XBFBolt/ember/design-export/index.html

Ember

Maya Chen Live · 42 min

Watch

38.1

°C± 0.7

↑ 0.3° / 10 min +1.0° since start

Estimated core temp · likely 37.4–38.8°C

36°Watch 38°Act 38.5°40°

## Can't estimate right now

High heart rate while sitting still

Your heart rate is up, but your body doesn't look like it's heating up. Ember won't show a number it can't stand behind.

Your plan Updated just now

You are heating up. Take your break now, not in 10 minutes.

Could reach 38.5° in about 10–25 min If you keep this pace. A break now resets the clock.

Next break

Now

5 min in shade

Water

Now

250 ml · last drink 22 min ago

Start my break I drank

Last 30 min HR 152 bpm · moving

Core estimate + range Skin 33.8°C

Heart rate and history stay on this phone. Not a medical device. How sure is Ember?

Preseason practice · Field 2 · started 4:05 PM · 12 straps live

# Team heat status

Air 31°C · Humidity 68% Heat index 36°C · High

## Players

Sorted by risk · ± is the measured 90% range · updates every 5 s

## Break plan

20 min on, 5 off

6 minto next team water break

Bring it forward: 3 players could reach 38.5° within 10–20 min. Each player gets 250 ml. Okafor and Brooks stay out until Ember shows Watch or OK.

Call break now Keep schedule

## Do this now

Act now

Pull J. Okafor (#22) and T. Brooks (#54) to the cooling tent. Both are over 38.5°C and still heating up.

Mark done

Next 5 min

Three players are over 38.0°C and heating up. Call the water break early. Check on S. Kim in person: Ember can't tell if their high heart rate is heat.

Rest of practice

Heat index stays high until about 6 PM. Keep 20 on, 5 off and 250 ml per break.

## Today

Athletes opted in to share status and core temp range. Heart rate and history stay on each athlete's phone. A triage signal, not an alarm or a medical device: it supports your judgment, it doesn't replace it.

Seaport site · Crew B · Shift 7:00 AM to 3:30 PM

# Heat safety events

Air 30°C Heat index 34°C · High

## You see safety events only

Temperatures, heart rate and forecasts stay private to each worker. You're told when someone needs help, not how their body is doing minute to minute.

## Events

## Crew break plan

45 on, 15 off

11:45next crew break · in 12 min

Set from today's heat index. Water and shade for everyone, about 500 ml per hour each. Ember suggests the schedule; you can change it.

## Crew

## Who sees what

Shared with you

- Overheating alerts
- Rest breaks taken
- Estimate unavailable

Only the worker sees

- Core temp estimate and range
- Heart rate and skin temp
- Motion and other sensor readings
- Full history and location
