XBFBolt/ember/analysis/ember_all_by_sex.png

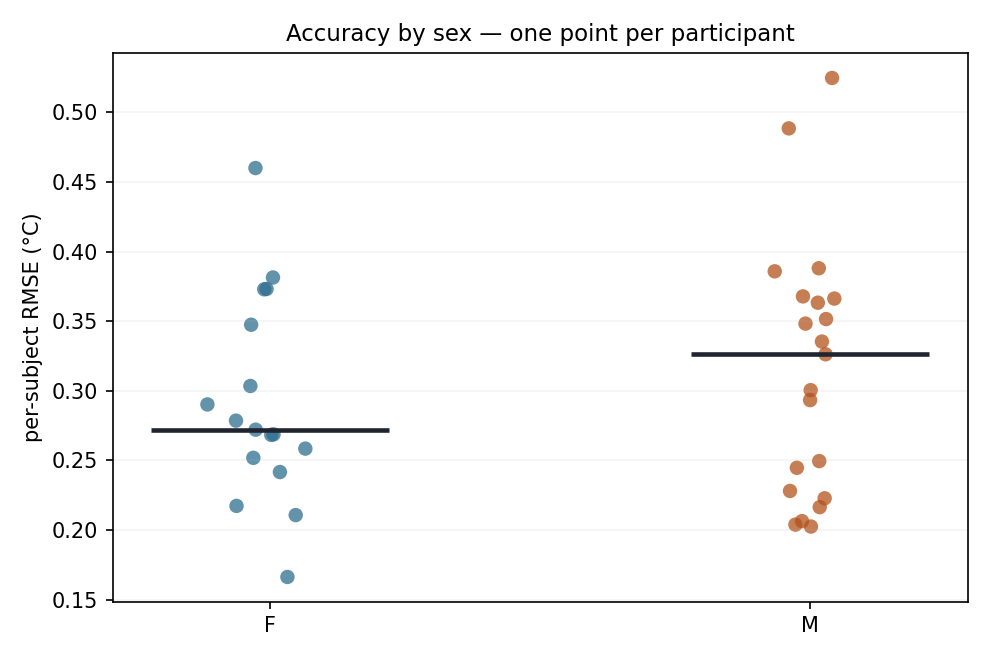
analysis/ember_all_by_sex.png
