XBFBolt/ember/analysis/judges_coverage.png

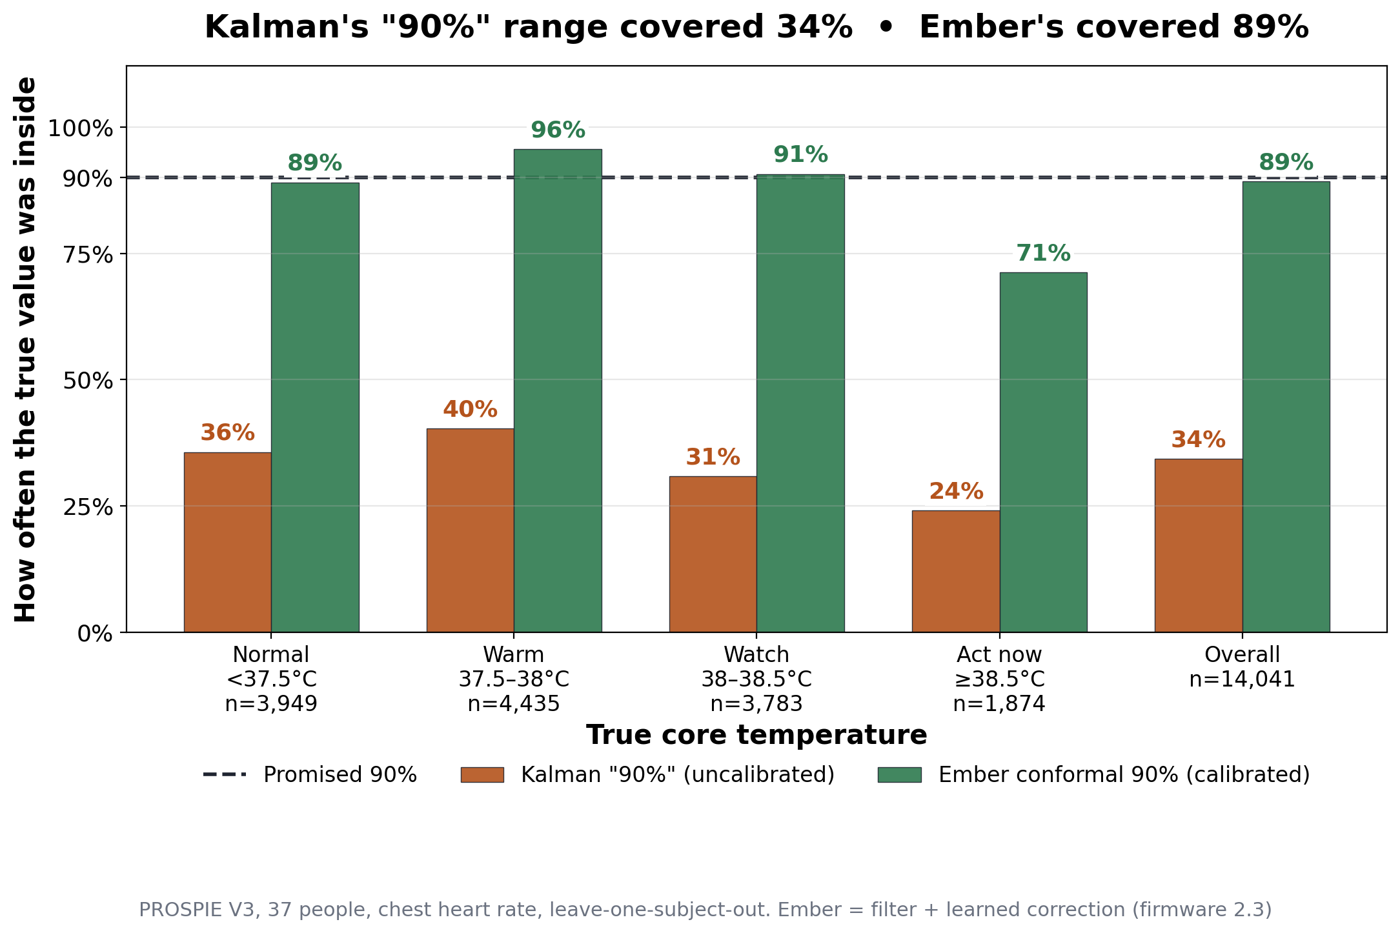
analysis/judges_coverage.png
