XBFBolt/ember/analysis/judges_lag.png

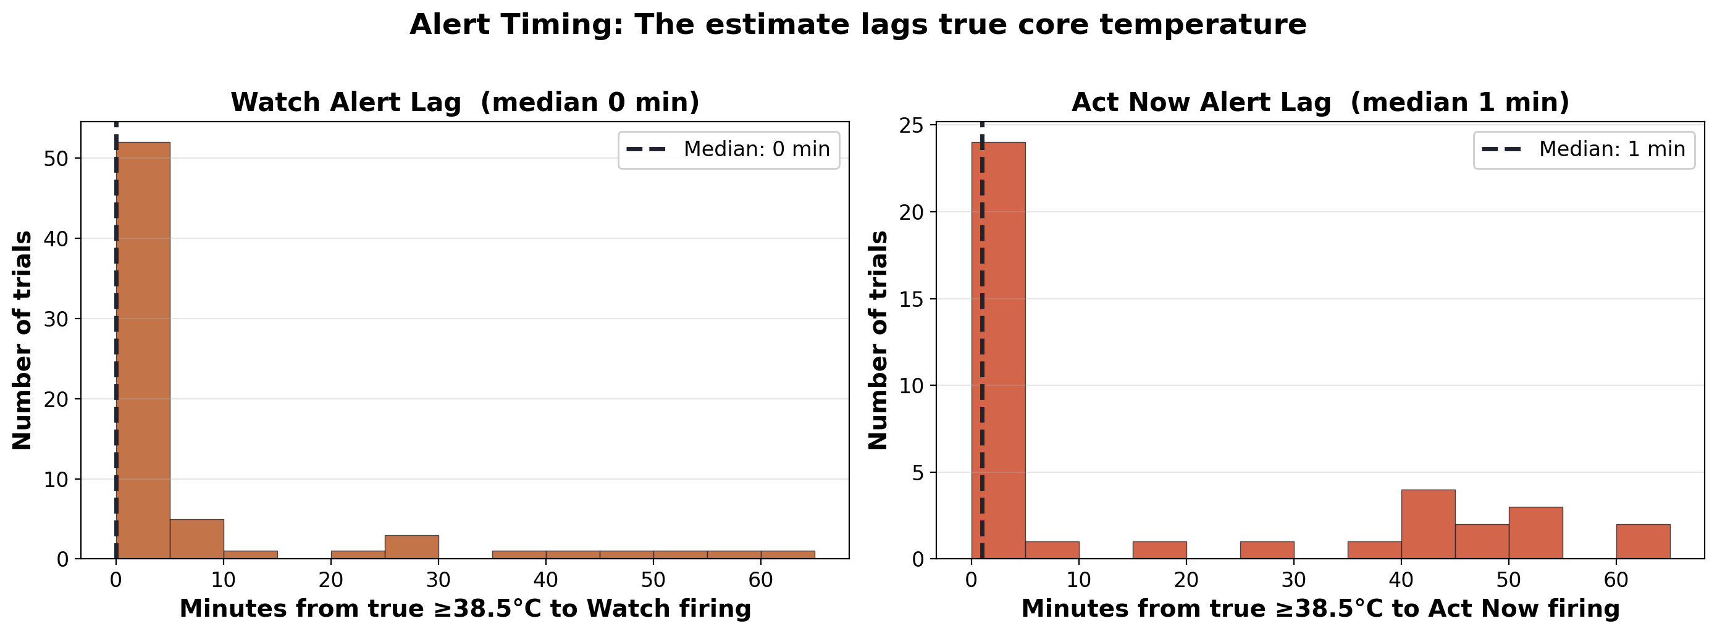
analysis/judges_lag.png
