XBFBolt/ember/analysis/judges_range.png

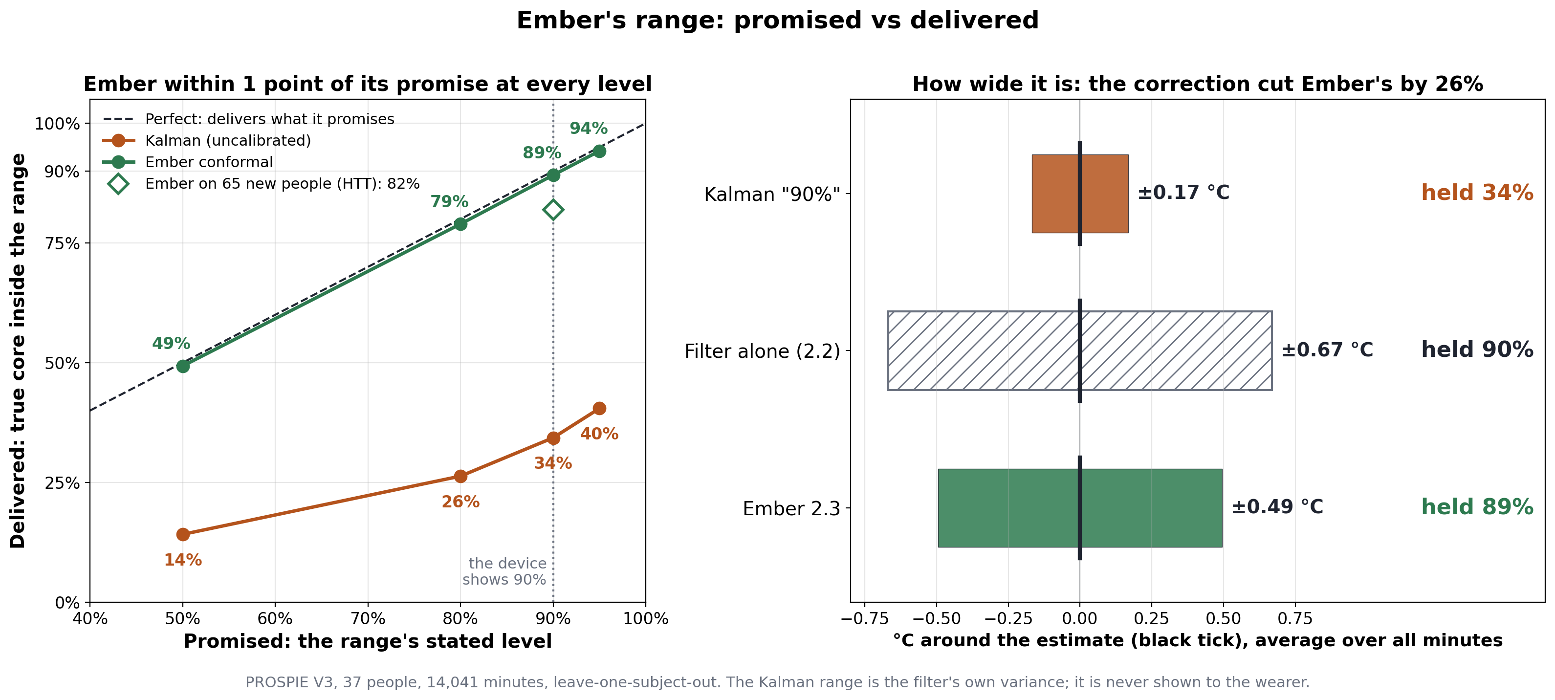
analysis/judges_range.png
