XBFBolt/ember/analysis/judges_trial_interval.png

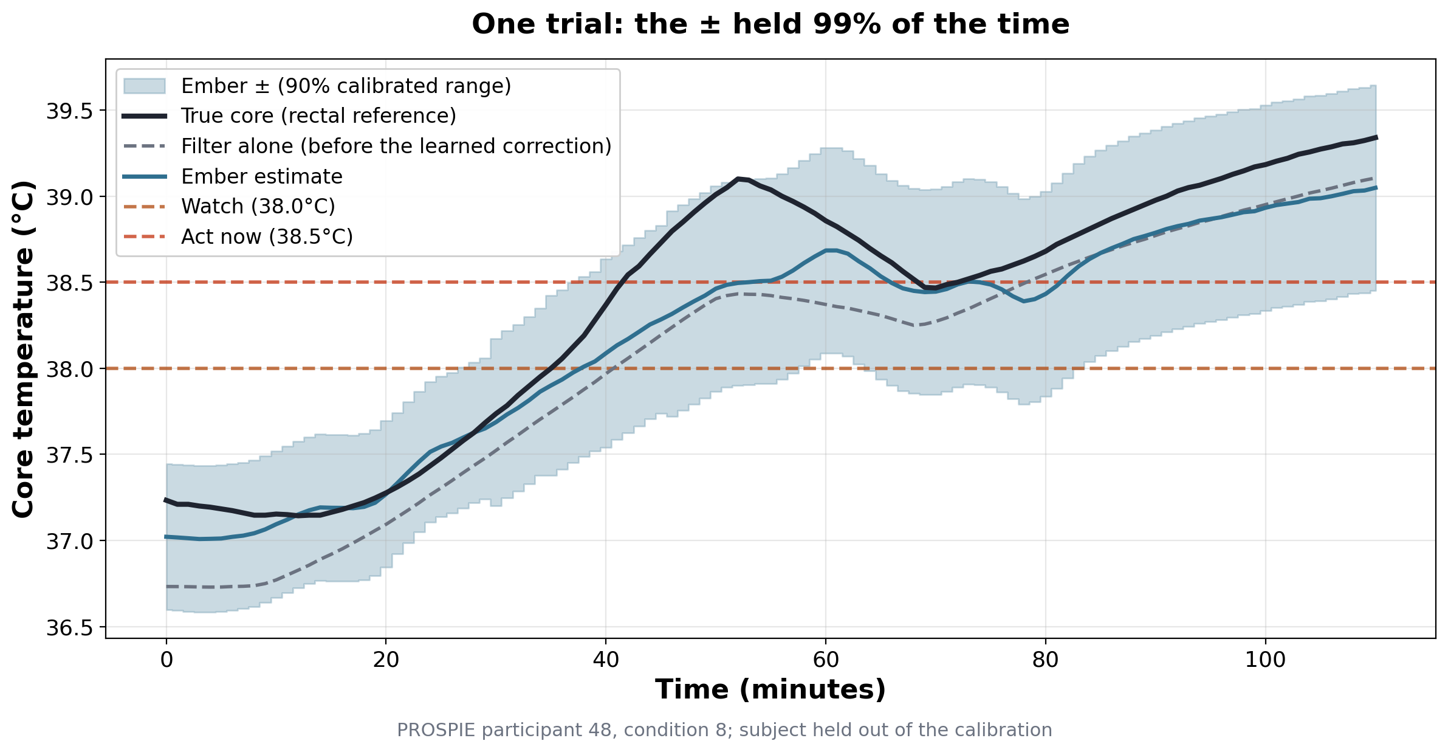
analysis/judges_trial_interval.png
