XBFBolt/ember/ember_schematic_v5.png

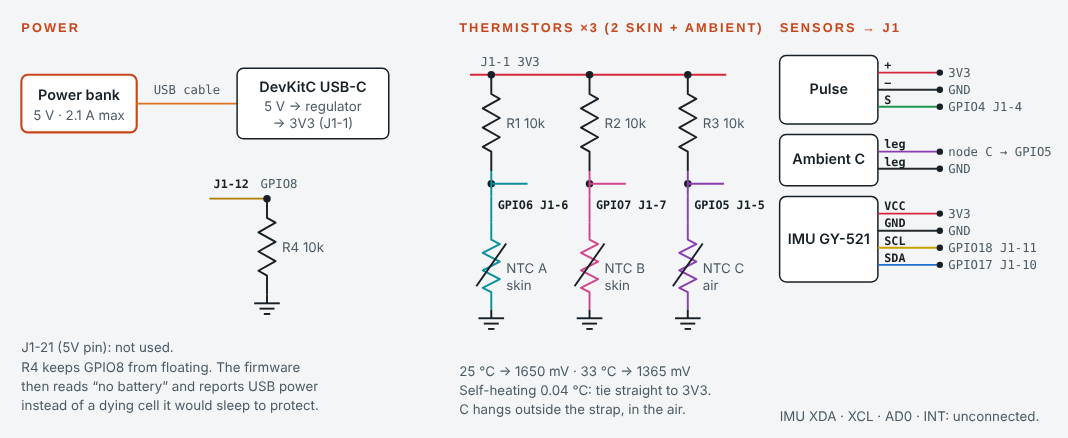
ember_schematic_v5.png
