XBFBolt/ember/figures/ember_by_sex.png

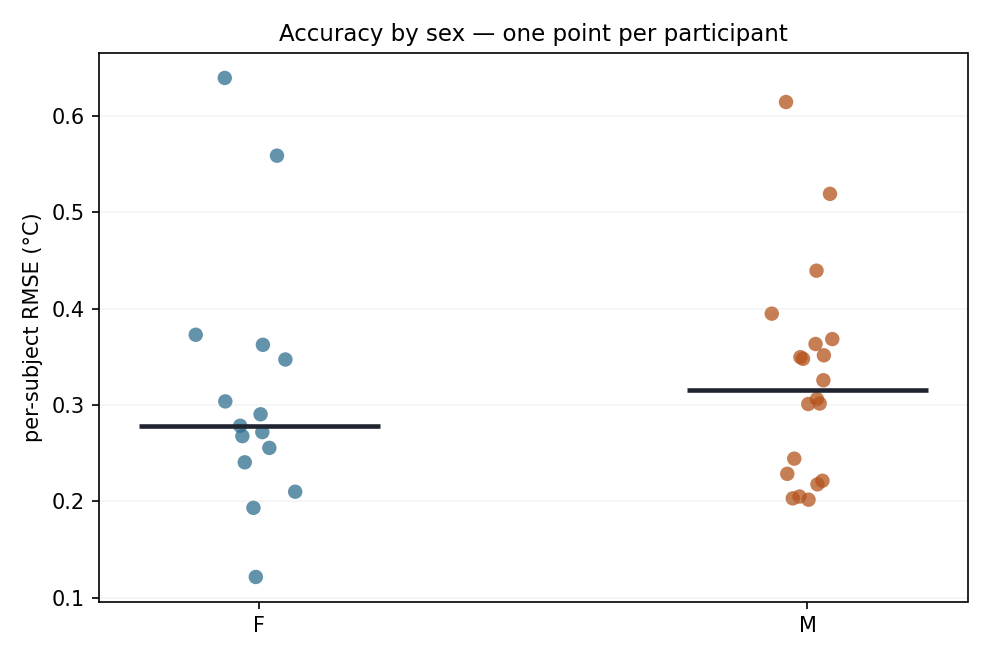
figures/ember_by_sex.png
