XBFBolt/ember/figures/judges_early_warning.png

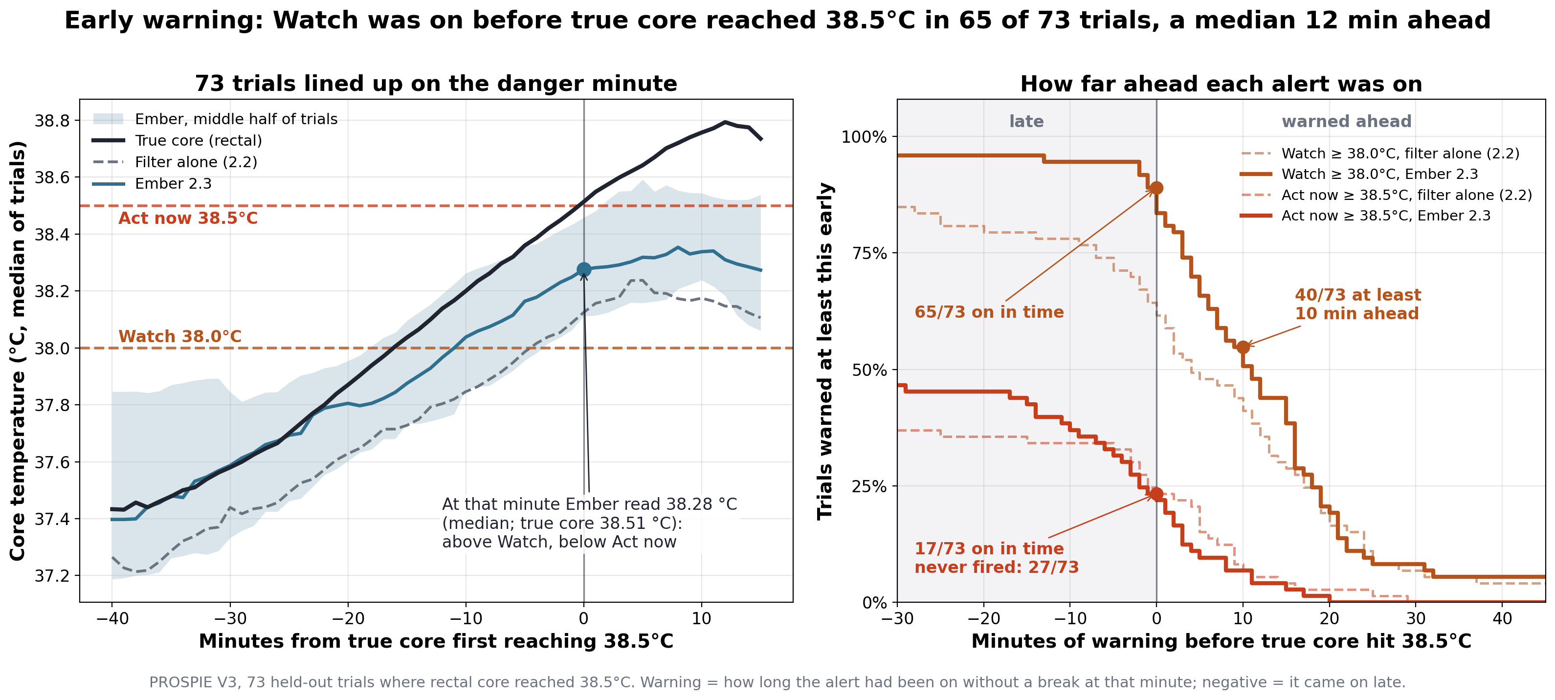
figures/judges_early_warning.png
