XBFBolt/ember/figures/judges_lag.png

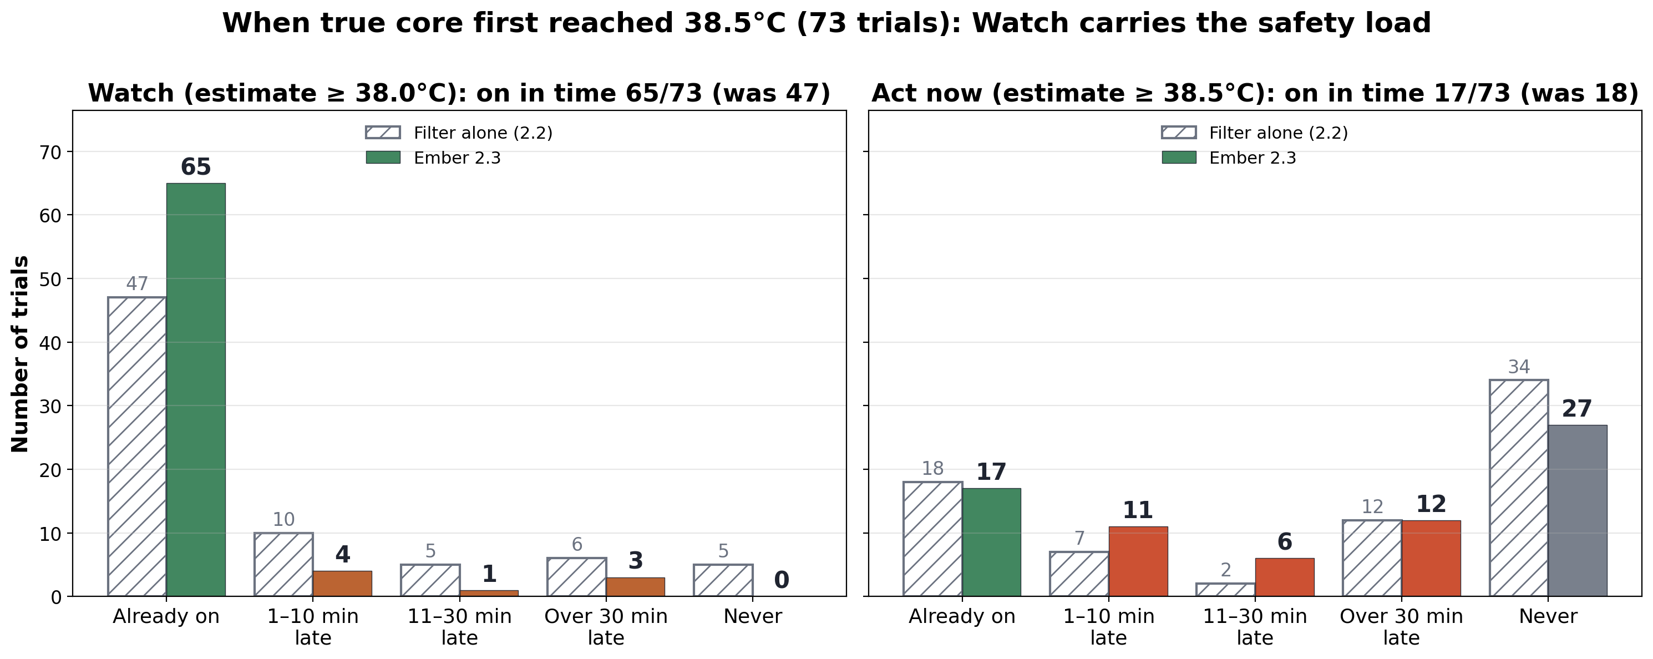
figures/judges_lag.png
