XBFBolt/ember/figures/judges_rmse.png

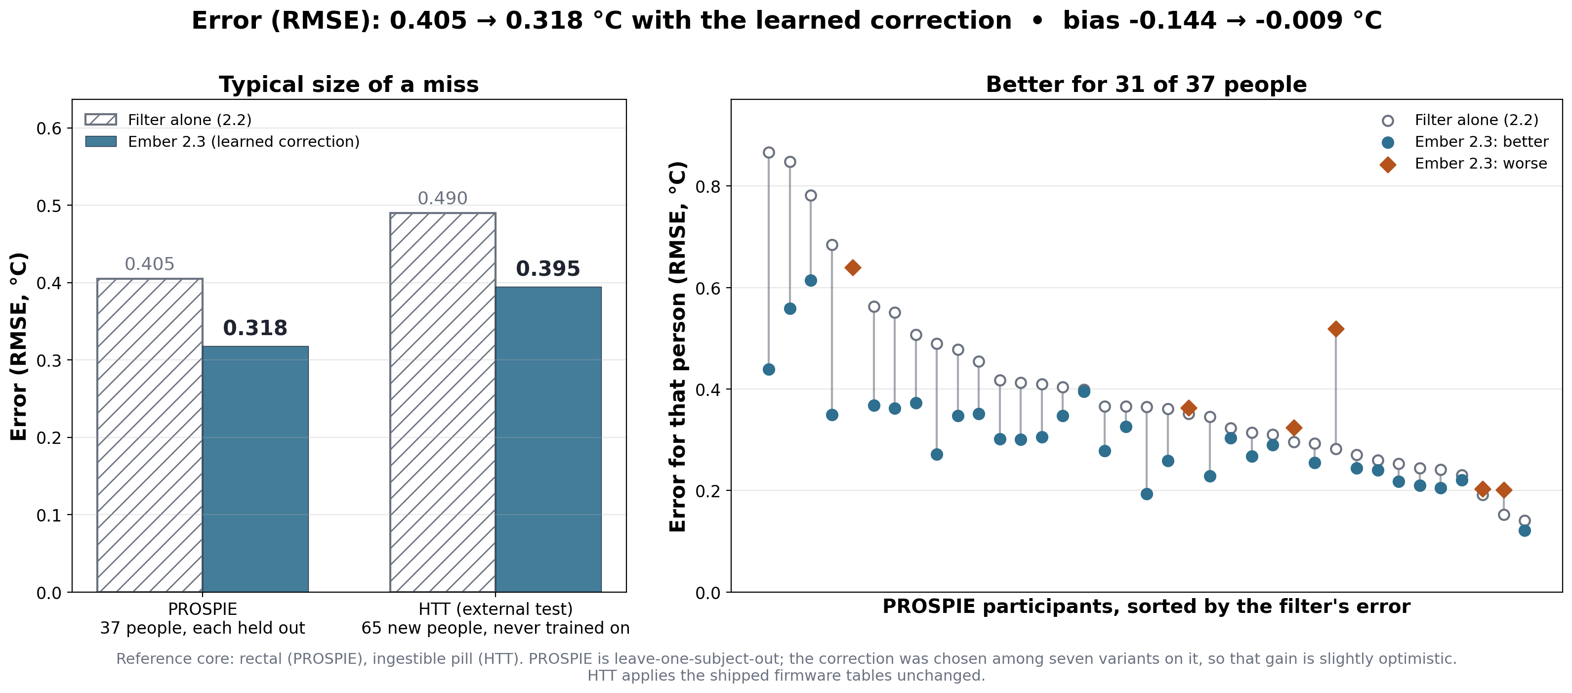
figures/judges_rmse.png
