XBFBolt/ember/figures/judges_trial_interval.png

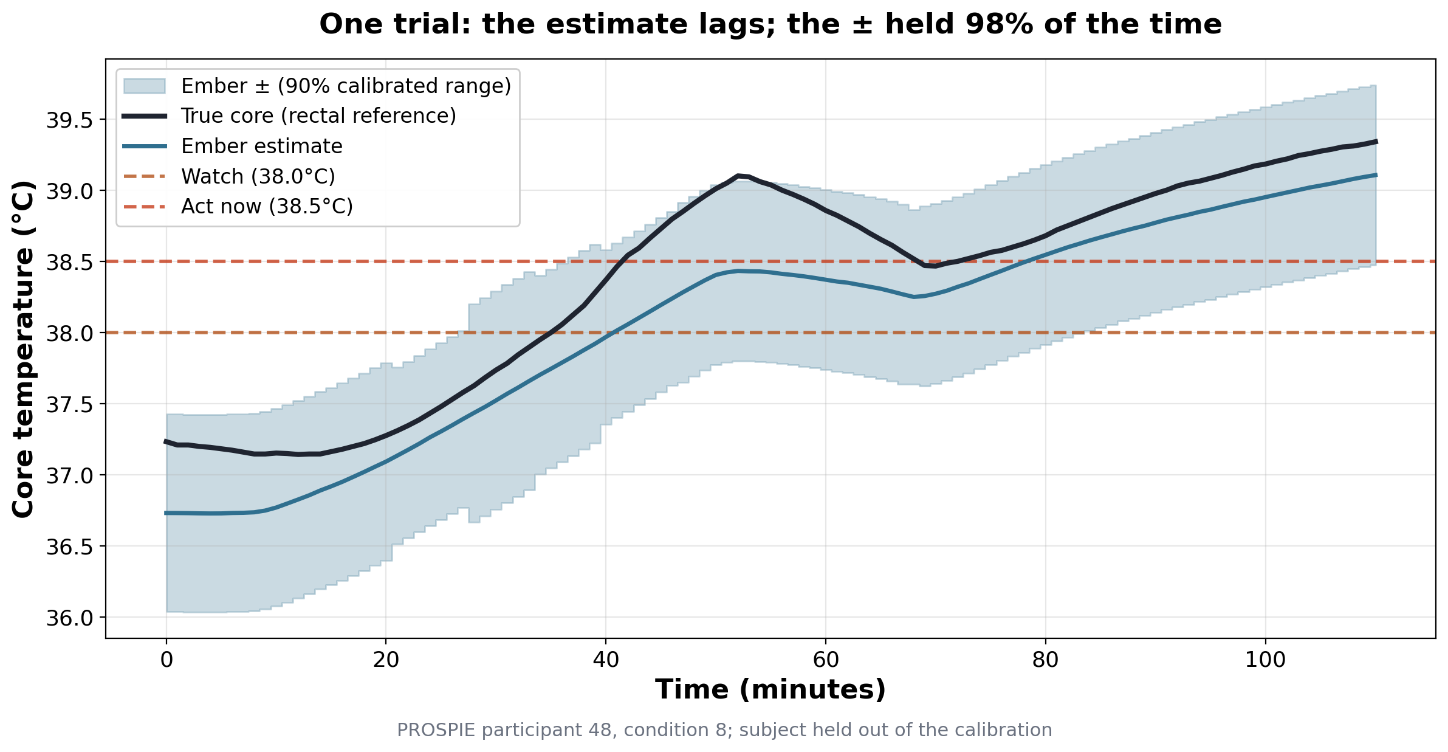
figures/judges_trial_interval.png
