XBFBolt/ember/hardware/cad/ember_underside.png

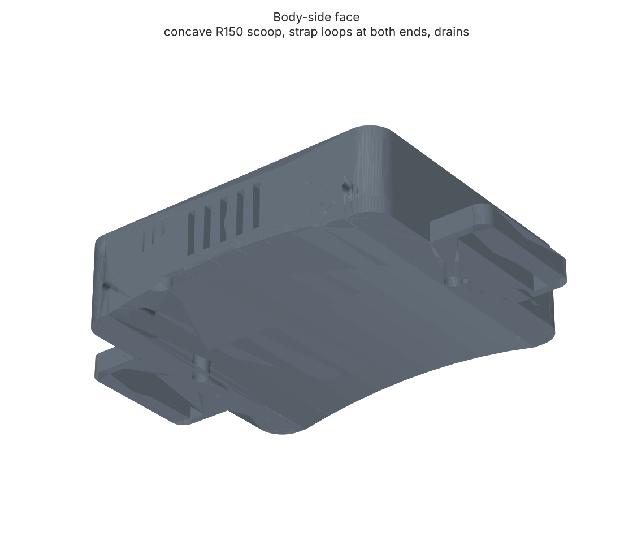
hardware/cad/ember_underside.png
