XBFBolt/ember/hardware/cad/ember_views.png

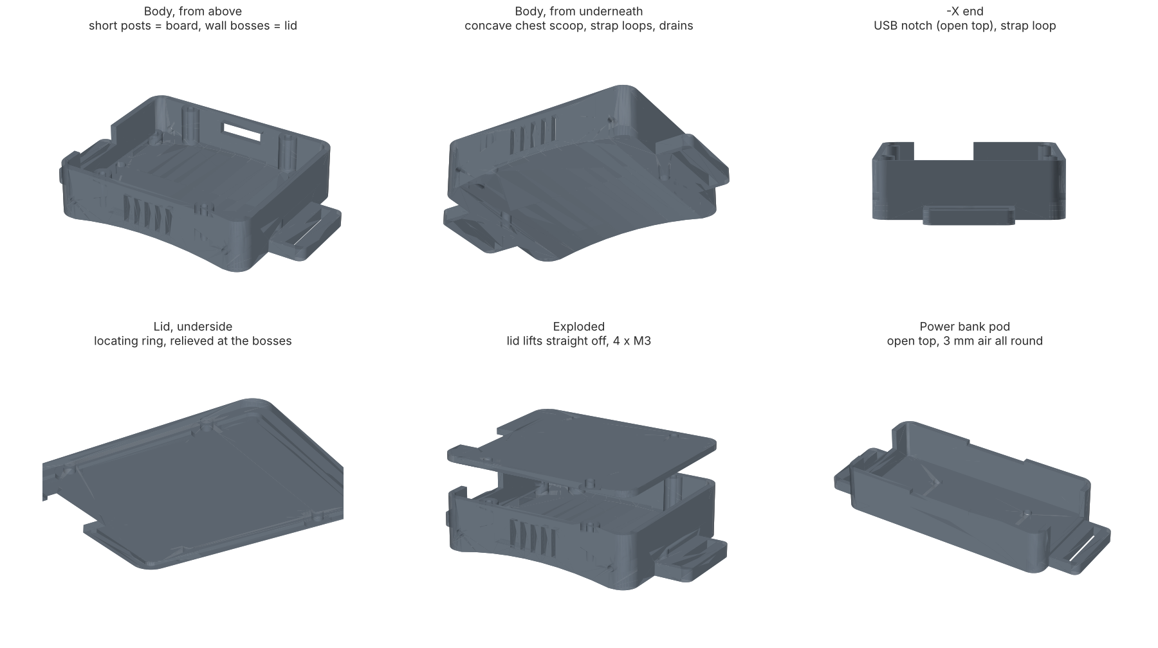
hardware/cad/ember_views.png
