XBFBolt/ember/hardware/ember_protoboard_v5.png

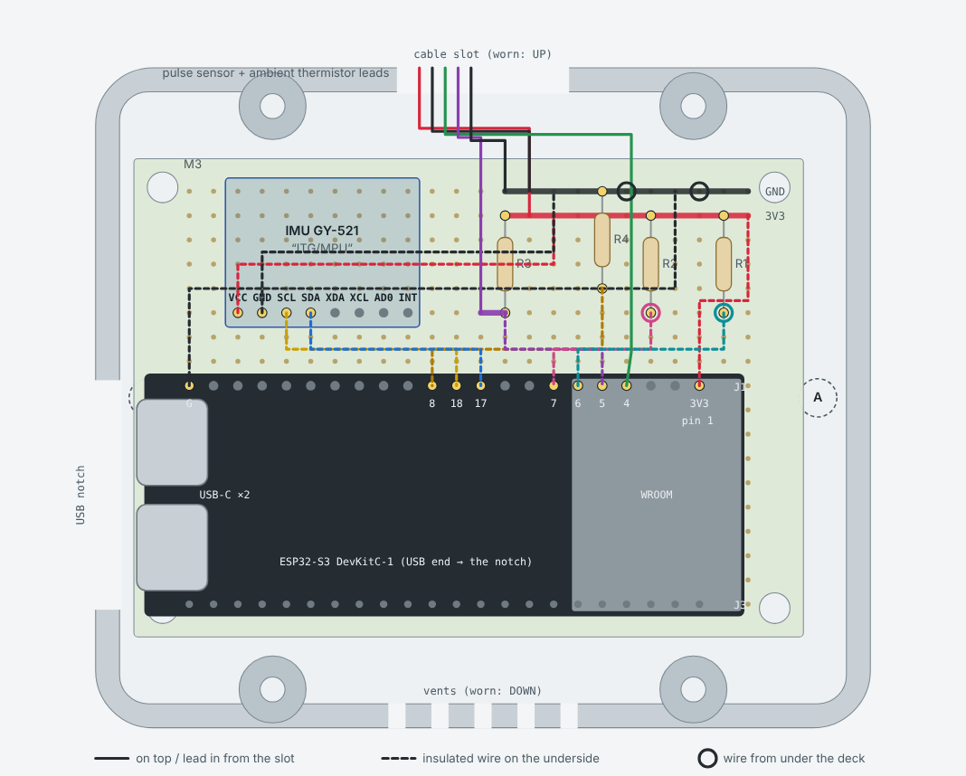
hardware/ember_protoboard_v5.png
