XBFBolt/ember/cad/ember_assembly.step

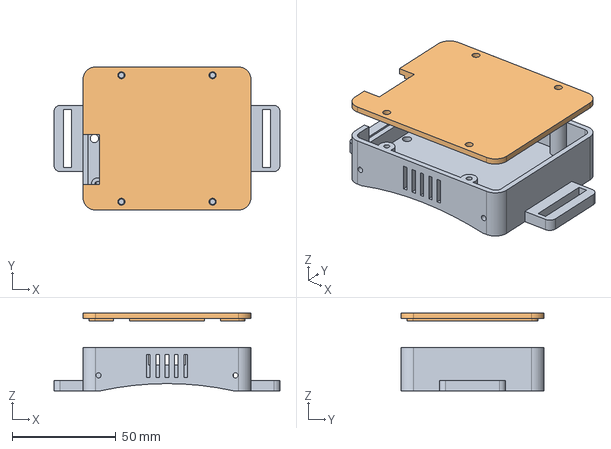
[picture p16: CAD file, 2026-10-24]
cad/ember_assembly.step
109.0 x 69.0 x 37.5 mm
