XBFBolt/ember/cad/ember_lid.step

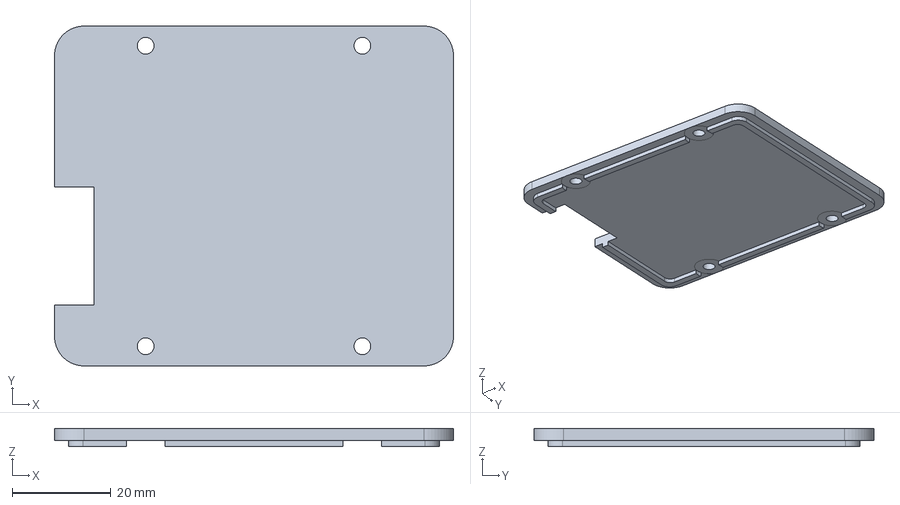
[picture p17: CAD file, 2026-10-24]
cad/ember_lid.step
81.0 x 69.0 x 3.70 mm
