XBFBolt/ember/hardware/cad/ember_pod.step

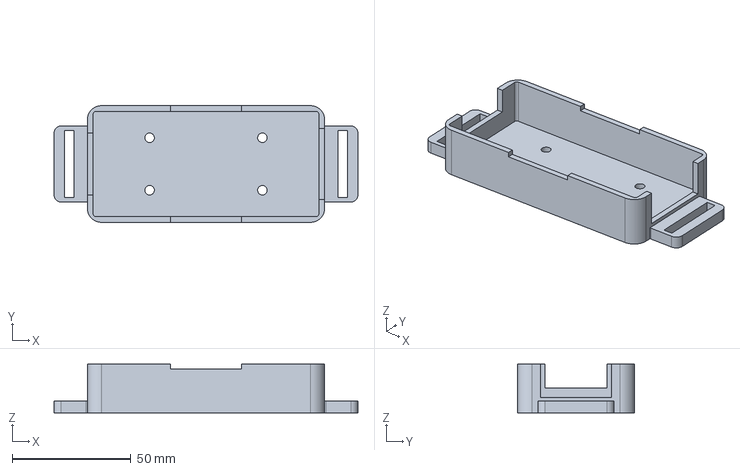
[picture p18: CAD file, 2026-10-25]
hardware/cad/ember_pod.step
127.9 x 49.1 x 20.5 mm
