XBFBolt/ember/hardware/cad/ember_body.stl

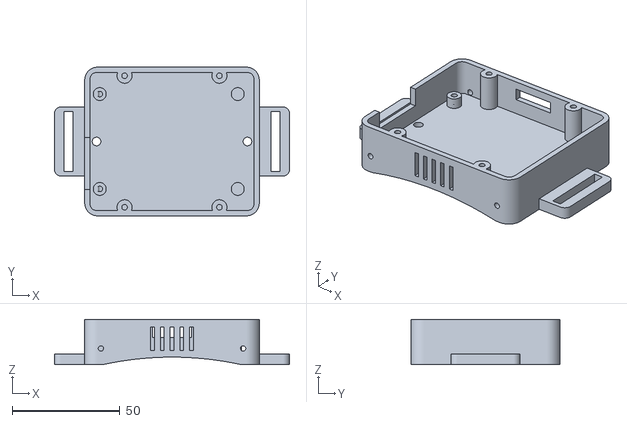
[picture p19: CAD file, 2026-10-25]
hardware/cad/ember_body.stl
109.0 x 69.0 x 21.0
