XBFBolt/ember/(list of files, cad)

Other CAD files:
cad/ember_body.step
cad/ember_pod.stl
cad/ember_assembly.stl
cad/ember_lid.stl
