XBFBolt/ember/hardware/wiring_v5.html

# Ember wiring, v5

One pulse sensor, three thermistors (two skin, one ambient) and the IMU. The SHT40 and pulse sensor B are gone. The ambient thermistor takes GPIO5 with its own 10k resistor (R3), wired exactly like the skin thermistors.

## Pin map

ESP32-S3 pin | Goes to
3V3 (J1-1) | 3V3 rail: pulse +, IMU VCC, R1, R2, R3
G (J1-22) | GND rail: pulse −, IMU GND, the far leg of all three thermistors, R4
GPIO4 (J1-4) | Pulse sensor S
GPIO5 (J1-5) | Node C: R3 + ambient thermistor (was pulse B)
GPIO6 (J1-6) | Node A: R1 + skin thermistor A
GPIO7 (J1-7) | Node B: R2 + skin thermistor B
GPIO8 (J1-12) | R4 to GND (unchanged)
GPIO17 / 18 | IMU SDA / SCL only
5V (J1-21) | Not used. Power comes in through USB-C from the power bank.

## System

## Schematic

## Protoboard layout (top view)

## Every connection

# | From | To | How | ✓

1 | J1-22 G | GND rail | underside wire
2 | J1-1 3V3 | 3V3 rail | underside wire
3 | R4 top lead | J1-12 GPIO8 | underside wire
4 | R3 lower lead (node C) | J1-5 GPIO5 | underside wire
5 | R2 lower lead (node B) | J1-7 GPIO7 | underside wire
6 | R1 lower lead (node A) | J1-6 GPIO6 | underside wire
7 | IMU VCC | 3V3 rail | underside wire
8 | IMU GND | GND rail | underside wire
9 | IMU SCL | J1-11 GPIO18 | underside wire
10 | IMU SDA | J1-10 GPIO17 | underside wire
11 | Pulse + | 3V3 rail | lead from the slot
12 | Pulse - | GND rail | lead from the slot
13 | Pulse S | J1-4 GPIO4 | lead from the slot
14 | Ambient thermistor C, one leg | Pad beside R3 lower lead | lead from the slot
15 | Pad beside R3 lower lead | R3 lower lead (node C) | solder bridge
16 | Ambient thermistor C, other leg | GND rail | lead from the slot
17 | Thermistor A, one leg | R1 lower lead (node A) | wire from under the deck
18 | Thermistor A, other leg | GND rail | wire from under the deck
19 | Thermistor B, one leg | R2 lower lead (node B) | wire from under the deck
20 | Thermistor B, other leg | GND rail | wire from under the deck

## How it's worn
