XBFBolt/ember/analysis/external_htt_results.txt

========================================================================
 EMBER EXTERNAL TEST: PROSPIE calibration on the HTT dataset
========================================================================

 Calibration: firmware/ember/conformal_table.h, unchanged
   (Prospie dataset_open access V3.xlsx (HR: Equivital chest ECG, Polar chest strap))
 Test data:   HTT, DOI 10.17632/g5sb382smp.1, CC BY 4.0, never used to fit

loaded HTT data set.xlsx
  65 subjects, 128 trials (2 dropped: no usable core or HR)
  sex: {'F': 32, 'M': 33}
  trials by condition: {'heat': 65, 'neutral': 63}
  core method: {'TP': 118, 'blank': 6, 'RP': 4}
  core set missing: 29 out of 34-42 C, 242 pill-in-stomach, 369 drinking dips; HR out of range 7
  13554 minutes, 13159 scored, 13516 with HR; core 35.98-39.11 C
  ambient median: heat 40.1 C, neutral 22.5 C; heat-sheet trials logged under 30 C: 2

========================================================================
 1. HEADLINE: Ember 2.3 on 65 new people, next to PROSPIE
========================================================================

                                     PROSPIE LOSO     HTT filter  HTT Ember 2.3
  error (RMSE, °C)                          0.318          0.490          0.395
  bias (°C)                                -0.009         -0.066         +0.104
  90% coverage                              89.2%          81.4%          82.0%
  mean ± (°C)                                0.49           0.66           0.51
  coverage at true ≥38.5                    71.2%          81.8%          90.0%
  Kalman "90%" coverage                     34.3%          26.7%          26.7%
  Watch on at true 38.5                        65             38             39
  Watch never fired                             0              2              1
  Act now on at true 38.5                      17             19             14
  Act now never fired                          27             12             11
  Act now false alarm trials                   13             26             25

  Alert rows count trials. PROSPIE LOSO: 73 reached 38.5, 55 did not; HTT filter: 46 reached 38.5, 82 did not; HTT Ember 2.3: 46 reached 38.5, 82 did not.

  HTT, Ember 2.3, 95% intervals over people: coverage [77.5%, 86.3%], RMSE [0.345, 0.450], bias [+0.042, +0.167]
  65 people, 128 trials, 13159 scored minutes; correction on for 100.0% of them
  The correction lowered RMSE for 54 of 65 people.

========================================================================
 2. COVERAGE BY TRUE TEMPERATURE
========================================================================

                  band  minutes  coverage     bias
        normal (<37.5)     2317     64.8%   +0.382
      warm (37.5-38.0)     4795     84.0%   +0.107
     watch (38.0-38.5)     4974     86.3%   +0.010
       act now (≥38.5)     1073     90.0%   -0.074

========================================================================
 3. HEAT vs THERMONEUTRAL
========================================================================

                                             heat        neutral
  error (RMSE, °C)                          0.405          0.386
  bias (°C)                                +0.121         +0.090
  90% coverage                              83.5%          80.8%
  mean ± (°C)                                0.52           0.50
  coverage at true ≥38.5                    90.2%          89.0%
  Kalman "90%" coverage                     27.3%          26.2%
  Watch on at true 38.5                        31              8
  Watch never fired                             0              1
  Act now on at true 38.5                      11              3
  Act now never fired                           6              5
  Act now false alarm trials                   14             11

  Alert rows count trials. heat: 36 reached 38.5, 29 did not; neutral: 10 reached 38.5, 53 did not.
  heat: coverage 95% CI over people [77.7%, 88.5%]
  neutral: coverage 95% CI over people [74.8%, 86.7%]

========================================================================
 4. WOMEN vs MEN
========================================================================

                                                F              M
  error (RMSE, °C)                          0.360          0.421
  bias (°C)                                +0.037         +0.158
  90% coverage                              83.3%          80.9%
  mean ± (°C)                                0.52           0.50
  coverage at true ≥38.5                    88.4%          91.6%
  Kalman "90%" coverage                     23.2%          29.5%
  Watch on at true 38.5                        20             19
  Watch never fired                             1              0
  Act now on at true 38.5                       7              7
  Act now never fired                           6              5
  Act now false alarm trials                   17              8

  Alert rows count trials. F: 25 reached 38.5, 38 did not; M: 21 reached 38.5, 44 did not.
  bias M - F: +0.121 °C, 95% CI [-0.000, +0.242]
  rmse M - F: +0.061 °C, 95% CI [-0.029, +0.155]

========================================================================
 5. WHERE THE MISSES ARE
========================================================================

                                      PROSPIE LOSO      HTT
  estimate too high (true below)              3.9%    12.2%
  estimate too low (true above)               6.9%     5.8%
  Too low is the dangerous direction: the wearer is hotter than the range says.

  By time into the trial (HTT):
     minutes      n  coverage     bias  too high  too low
     [0, 10)   1216     73.4%   +0.029     14.6%    12.0%
    [10, 30)   2480     79.2%   -0.092      5.3%    15.5%
    [30, 60)   3539     89.1%   +0.032      6.5%     4.5%
    [60, 90)   3047     83.1%   +0.200     15.3%     1.6%
   [90, 121)   2877     78.1%   +0.291     20.8%     1.1%

  Trials that ran the full two hours (medians):
              minutes     HR  true core   Ember
  heat        [0, 10)    108      37.18   37.37
  heat       [10, 30)    120      37.48   37.52
  heat       [30, 60)    128      37.91   37.95
  heat       [60, 90)    135      38.17   38.30
  heat      [90, 121)    143      38.27   38.50
  neutral     [0, 10)    110      37.39   37.34
  neutral    [10, 30)    121      37.73   37.54
  neutral    [30, 60)    122      37.96   37.87
  neutral    [60, 90)    124      38.03   38.11
  neutral   [90, 121)    127      38.00   38.23
  Late in a long steady walk, heart rate keeps rising while core levels off
  (cardiovascular drift). ECTemp reads the rising heart rate as rising core,
  so Ember over-reads: more false alarms, not more misses.

========================================================================
 6. ALERT TIMING CAVEAT: these trials stop early
========================================================================

  The HTT protocol stopped a trial at core 39.0 °C or HR 180 bpm. After true
  core first reached 38.5 °C, HTT trials had a median of 26 min of data left (IQR 13-40);
  PROSPIE trials had 53 min (IQR 11-65). "Act now never fired" means "not before
  the trial ended", so the two datasets' alert counts are not directly comparable.
  Of the 11 HTT trials where Act now never fired, 10 had Watch on by the end.

========================================================================
 7. SENSITIVITY: is it the cleaning or the reference?
========================================================================

                                       all trials pill (TP) only    no dip rule
  error (RMSE, °C)                          0.395          0.397          0.440
  bias (°C)                                +0.104         +0.105         +0.124
  90% coverage                              82.0%          81.9%          80.6%
  mean ± (°C)                                0.51           0.51           0.51
  coverage at true ≥38.5                    90.0%          89.2%          89.7%
  Kalman "90%" coverage                     26.7%          26.5%          26.1%
  Watch on at true 38.5                        39             36             39
  Watch never fired                             1              1              2
  Act now on at true 38.5                      14             14             15
  Act now never fired                          11             11             13
  Act now false alarm trials                   25             22             23

  Alert rows count trials. all trials: 46 reached 38.5, 82 did not; pill (TP) only: 43 reached 38.5, 75 did not; no dip rule: 50 reached 38.5, 78 did not.

========================================================================
 8. WHAT THIS DOES AND DOES NOT SHOW
========================================================================

  - Same maths as the device (header coefficients and tables), run on
    people, a lab and a core sensor it was never fitted to.
  - Reference differs: ingestible pill here, rectal in PROSPIE. Pill and
    rectal disagree by a few tenths during exercise, so part of any
    coverage loss is the reference, not Ember.
  - The HR sensor in the HTT treadmill trials is not stated; PROSPIE's
    was a chest ECG or Polar strap. Ember's own pulse sensor is neither.
  - One protocol (steady walking): it tests the step from "chamber
    conditions" to "walking for two hours", not every kind of work.
  - Cleaning rules (load_htt.py) were fixed before this script was run.

  wrote external_htt_results.json
