XBFBolt/ember/analysis/results_all_hr_types.txt

Ember evaluation
====================================================================

ECTemp coefficient self-check:
  [ok ] CT 36.5 -> HR   54.3 (expect 40-75)
  [ok ] CT 37.0 -> HR   78.5 (expect 65-95)
  [ok ] CT 38.0 -> HR  120.1 (expect 105-135)
  [ok ] CT 39.0 -> HR  152.5 (expect 135-170)
  [ok ] CT 40.0 -> HR  175.8 (expect 155-195)
  [ok ] model peaks at CT 42.05 (must be > 41.0)
  [ok ] inverse round trip -> 38.000000
  PASS

loaded Prospie dataset_open access V3.xlsx
  17264 rows x 58 columns
  columns: ['Condition', 'Time', 'Activity code', 'Participant', 'Sex', 'Age', 'Bodymasskg', 'Heightcm', 'Bodyfat%', 'VO2peakmlkgmin', 'Acclimationstatus', 'Trainingstatus', 'Clothing', 'Environmental temperature (chamber or cooling area outside chamber) Humidity', 'Environmental temperature (chamber or cooling area outside chamber) Temp', 'Environmental temperature (chamber or cooling area outside chamber) Wind', 'Environmental (Inside clothing) Tfront', 'Environmental (Inside clothing) Rhfront', 'Environmental (Inside clothing) Tback', 'Environmental (Inside clothing) Rhback', 'Activity workrest', 'OxygenConsumption ml.kg.min', 'Treadmillsettings Speedkm.hr-1', 'Treadmillsettings Gradient%', 'Solar present'] ...

  column mapping chosen:
    subject    <- 'Participant'
    sex        <- 'Sex'
    condition  <- 'Condition'
    minute     <- 'Time'
    hr         <- 'InsulatedskinTemp HR'
    hr_type    <- 'InsulatedskinTemp HRtype'
    core_c     <- 'Corerectal'

  WARNING: inconsistent sex code for participant(s) ['17', '18']; sex set to missing (left out of the by-sex analysis)

  17264 minutes kept, 17196 with core temp (scored), 11953 with HR
  40 subjects, 155 trials, 9 conditions; every trial is 1-minute spaced
  sex: {'F': 17, 'M': 21}
  trials by HR sensor: finger PPG 28, Equivital chest ECG 103, Polar chest strap 24
  core temp range 35.96 - 39.53 C

  Shipped estimate: ECTemp + learned correction (firmware 2.3), on for 100.0% of scored minutes.
  Run with --no-correction for the filter alone (firmware 2.2).

====================================================================
 1. HONEST ACCURACY  (leave-one-subject-out)
====================================================================
  n = 17196 samples, 40 subjects
  RMSE   0.310 C
  MAE    0.246 C
  bias   -0.023 C
  95% limits of agreement  -0.63 to +0.58 C
  R^2    0.6889

  For reference, published figures for this algorithm:
    original paper (Buller 2013)           RMSE 0.30, R^2 0.71
    USARIEM product page                   RMSE 0.30, LoA +/-0.63
    independent standardized benchmark     RMSE 0.41 (D1), 0.66 (D2)
                                           R^2  0.47 (D1), -0.40 (D2)

  Detecting core temp >= 38.0 C (prevalence 42%)
    sensitivity 0.732   specificity 0.860
    missed 1933 of 7212 elevated samples
  Benchmark reference: sensitivity 0.71 (D1), 0.33 (D2)

====================================================================
 2. IS THE UNCERTAINTY HONEST?
====================================================================
   nominal |   Kalman   width | conformal   width
  --------------------------------------------------
      0.50 |    0.135   0.143 |     0.495   0.417
      0.80 |    0.254   0.272 |     0.785   0.759
      0.90 |    0.328   0.349 |     0.891   0.983
      0.95 |    0.386   0.416 |     0.945   1.197

  A 90% interval that covers far less than 90% of the time is
  worse than no interval, because a user acts on it.

====================================================================
 3. DOES IT WORK EQUALLY WELL FOR EVERYONE?
====================================================================
  F  n_subj=17  RMSE 0.296  bias -0.004  R^2 +0.684  90% coverage 0.905
  M  n_subj=21  RMSE 0.323  bias -0.040  R^2 +0.688  90% coverage 0.880

  BIAS difference (M minus F): -0.036 C <- primary
    bootstrap 95% CI over subjects [-0.134, +0.065]  includes zero

  RMSE difference (M minus F): +0.027 C
    bootstrap 95% CI over subjects [-0.023, +0.074]  includes zero

  Note on metric choice: a systematic offset between groups
  shows up in BIAS and barely moves RMSE. Audit on bias, or
  you will declare a biased model fair.

  Context: published validations of this algorithm are
  overwhelmingly male. One 251-subject study had 36 women and
  ran no sex analysis; several others had none at all.

  By heart-rate sensor (trial's main sensor):
    finger PPG           n_subj=15  n= 3271  RMSE 0.315  bias -0.122  90% coverage 0.854
    Equivital chest ECG  n_subj=23  n=11084  RMSE 0.287  bias +0.026  90% coverage 0.925
    Polar chest strap    n_subj=14  n= 2841  RMSE 0.384  bias -0.097  90% coverage 0.800

====================================================================
 4. WHEN SHOULD THE DEVICE REFUSE TO ANSWER?
====================================================================
   answered    RMSE     MAE   width threshold
       100%   0.310   0.246   <= 0.623 C
        82%   0.301   0.237   <= 0.549 C
        63%   0.297   0.233   <= 0.530 C
        45%   0.283   0.222   <= 0.498 C
        26%   0.265   0.207   <= 0.418 C

  Pick the operating point deliberately and defend it. A device
  that answers 70% of the time and is right when it does beats one
  that always answers and is sometimes badly wrong.

wrote ember_all_results.png
wrote ember_all_by_sex.png
wrote ember_all_predictions.csv and ember_all_summary.json
