XBFBolt/ember/analysis/results_chest.txt

Ember evaluation
====================================================================

ECTemp coefficient self-check:
  [ok ] CT 36.5 -> HR   54.3 (expect 40-75)
  [ok ] CT 37.0 -> HR   78.5 (expect 65-95)
  [ok ] CT 38.0 -> HR  120.1 (expect 105-135)
  [ok ] CT 39.0 -> HR  152.5 (expect 135-170)
  [ok ] CT 40.0 -> HR  175.8 (expect 155-195)
  [ok ] model peaks at CT 42.05 (must be > 41.0)
  [ok ] inverse round trip -> 38.000000
  PASS

loaded Prospie dataset_open access V3.xlsx
  17264 rows x 58 columns
  columns: ['Condition', 'Time', 'Activity code', 'Participant', 'Sex', 'Age', 'Bodymasskg', 'Heightcm', 'Bodyfat%', 'VO2peakmlkgmin', 'Acclimationstatus', 'Trainingstatus', 'Clothing', 'Environmental temperature (chamber or cooling area outside chamber) Humidity', 'Environmental temperature (chamber or cooling area outside chamber) Temp', 'Environmental temperature (chamber or cooling area outside chamber) Wind', 'Environmental (Inside clothing) Tfront', 'Environmental (Inside clothing) Rhfront', 'Environmental (Inside clothing) Tback', 'Environmental (Inside clothing) Rhback', 'Activity workrest', 'OxygenConsumption ml.kg.min', 'Treadmillsettings Speedkm.hr-1', 'Treadmillsettings Gradient%', 'Solar present'] ...

  column mapping chosen:
    subject    <- 'Participant'
    sex        <- 'Sex'
    condition  <- 'Condition'
    minute     <- 'Time'
    hr         <- 'InsulatedskinTemp HR'
    hr_type    <- 'InsulatedskinTemp HRtype'
    core_c     <- 'Corerectal'

  WARNING: inconsistent sex code for participant(s) ['17', '18']; sex set to missing (left out of the by-sex analysis)

  HR sensor types kept: Equivital chest ECG, Polar chest strap
  670 HR readings from other sensors set to missing; 27 trials left with no HR dropped

  14098 minutes kept, 14041 with core temp (scored), 11283 with HR
  37 subjects, 128 trials, 9 conditions; every trial is 1-minute spaced
  sex: {'F': 15, 'M': 20}
  trials by HR sensor: Equivital chest ECG 103, Polar chest strap 25
  core temp range 35.96 - 39.51 C

  Shipped estimate: ECTemp + learned correction (firmware 2.3), on for 98.3% of scored minutes.
  Run with --no-correction for the filter alone (firmware 2.2).

====================================================================
 1. HONEST ACCURACY  (leave-one-subject-out)
====================================================================
  n = 14041 samples, 37 subjects
  RMSE   0.318 C
  MAE    0.250 C
  bias   -0.009 C
  95% limits of agreement  -0.63 to +0.61 C
  R^2    0.6741

  For reference, published figures for this algorithm:
    original paper (Buller 2013)           RMSE 0.30, R^2 0.71
    USARIEM product page                   RMSE 0.30, LoA +/-0.63
    independent standardized benchmark     RMSE 0.41 (D1), 0.66 (D2)
                                           R^2  0.47 (D1), -0.40 (D2)

  Detecting core temp >= 38.0 C (prevalence 40%)
    sensitivity 0.752   specificity 0.842
    missed 1404 of 5657 elevated samples
  Benchmark reference: sensitivity 0.71 (D1), 0.33 (D2)

====================================================================
 2. IS THE UNCERTAINTY HONEST?
====================================================================
   nominal |   Kalman   width | conformal   width
  --------------------------------------------------
      0.50 |    0.142   0.137 |     0.493   0.418
      0.80 |    0.263   0.261 |     0.790   0.764
      0.90 |    0.343   0.335 |     0.892   0.989
      0.95 |    0.405   0.400 |     0.942   1.204

  A 90% interval that covers far less than 90% of the time is
  worse than no interval, because a user acts on it.

====================================================================
 3. DOES IT WORK EQUALLY WELL FOR EVERYONE?
====================================================================
  F  n_subj=15  RMSE 0.310  bias +0.025  R^2 +0.635  90% coverage 0.904
  M  n_subj=20  RMSE 0.325  bias -0.034  R^2 +0.692  90% coverage 0.884

  BIAS difference (M minus F): -0.059 C <- primary
    bootstrap 95% CI over subjects [-0.158, +0.052]  includes zero

  RMSE difference (M minus F): +0.015 C
    bootstrap 95% CI over subjects [-0.051, +0.072]  includes zero

  Note on metric choice: a systematic offset between groups
  shows up in BIAS and barely moves RMSE. Audit on bias, or
  you will declare a biased model fair.

  Context: published validations of this algorithm are
  overwhelmingly male. One 251-subject study had 36 women and
  ran no sex analysis; several others had none at all.

  By heart-rate sensor (trial's main sensor):
    Equivital chest ECG  n_subj=23  n=11084  RMSE 0.287  bias +0.024  90% coverage 0.924
    Polar chest strap    n_subj=15  n= 2957  RMSE 0.416  bias -0.135  90% coverage 0.772

====================================================================
 4. WHEN SHOULD THE DEVICE REFUSE TO ANSWER?
====================================================================
   answered    RMSE     MAE   width threshold
       100%   0.318   0.250   <= 0.772 C
        82%   0.297   0.232   <= 0.561 C
        63%   0.284   0.221   <= 0.530 C
        45%   0.284   0.218   <= 0.500 C
        26%   0.254   0.195   <= 0.413 C

  Pick the operating point deliberately and defend it. A device
  that answers 70% of the time and is right when it does beats one
  that always answers and is sometimes badly wrong.

wrote ember_chest_results.png
wrote ember_chest_by_sex.png
wrote ember_chest_predictions.csv and ember_chest_summary.json
