XBFBolt/ember/analysis/ember_all_results.png

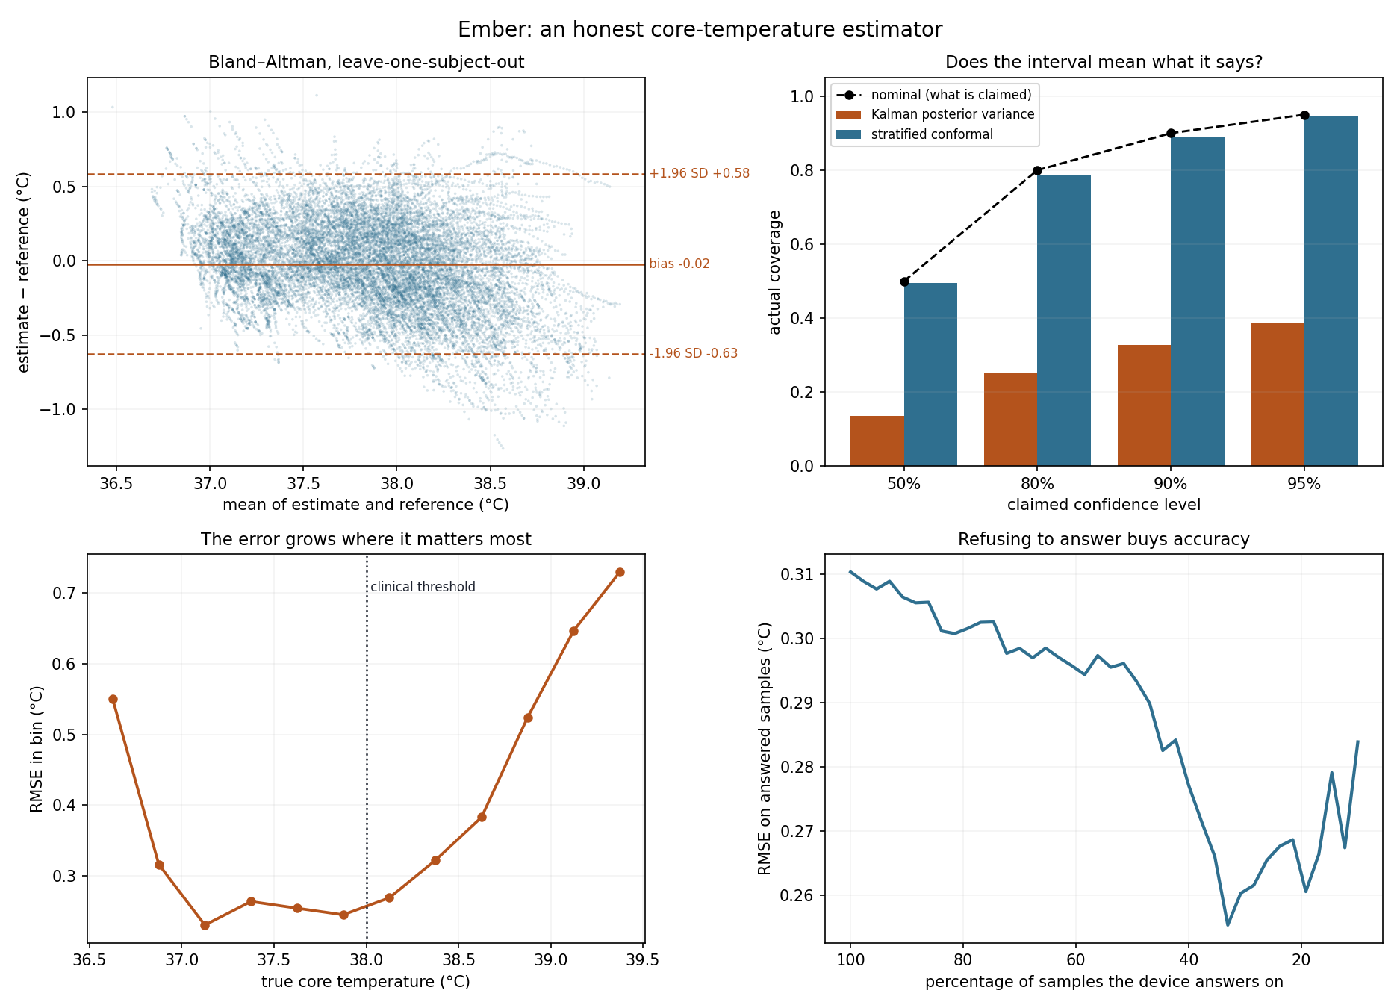
analysis/ember_all_results.png
