XBFBolt/ember/analysis/ember_results.png

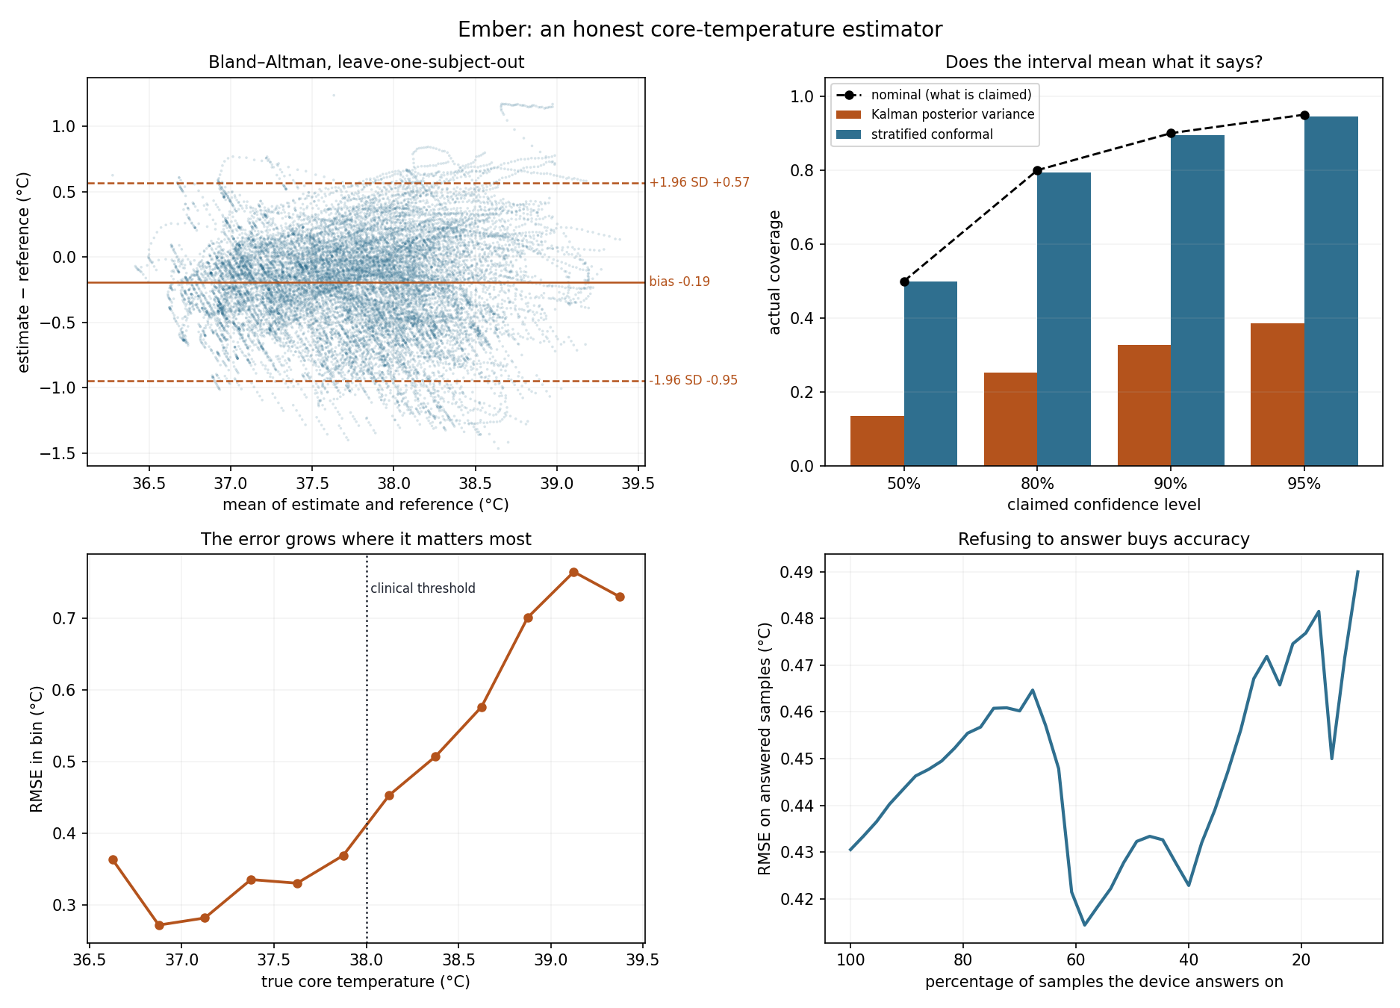
analysis/ember_results.png
