XBFBolt/ember/figures/ember_results.png

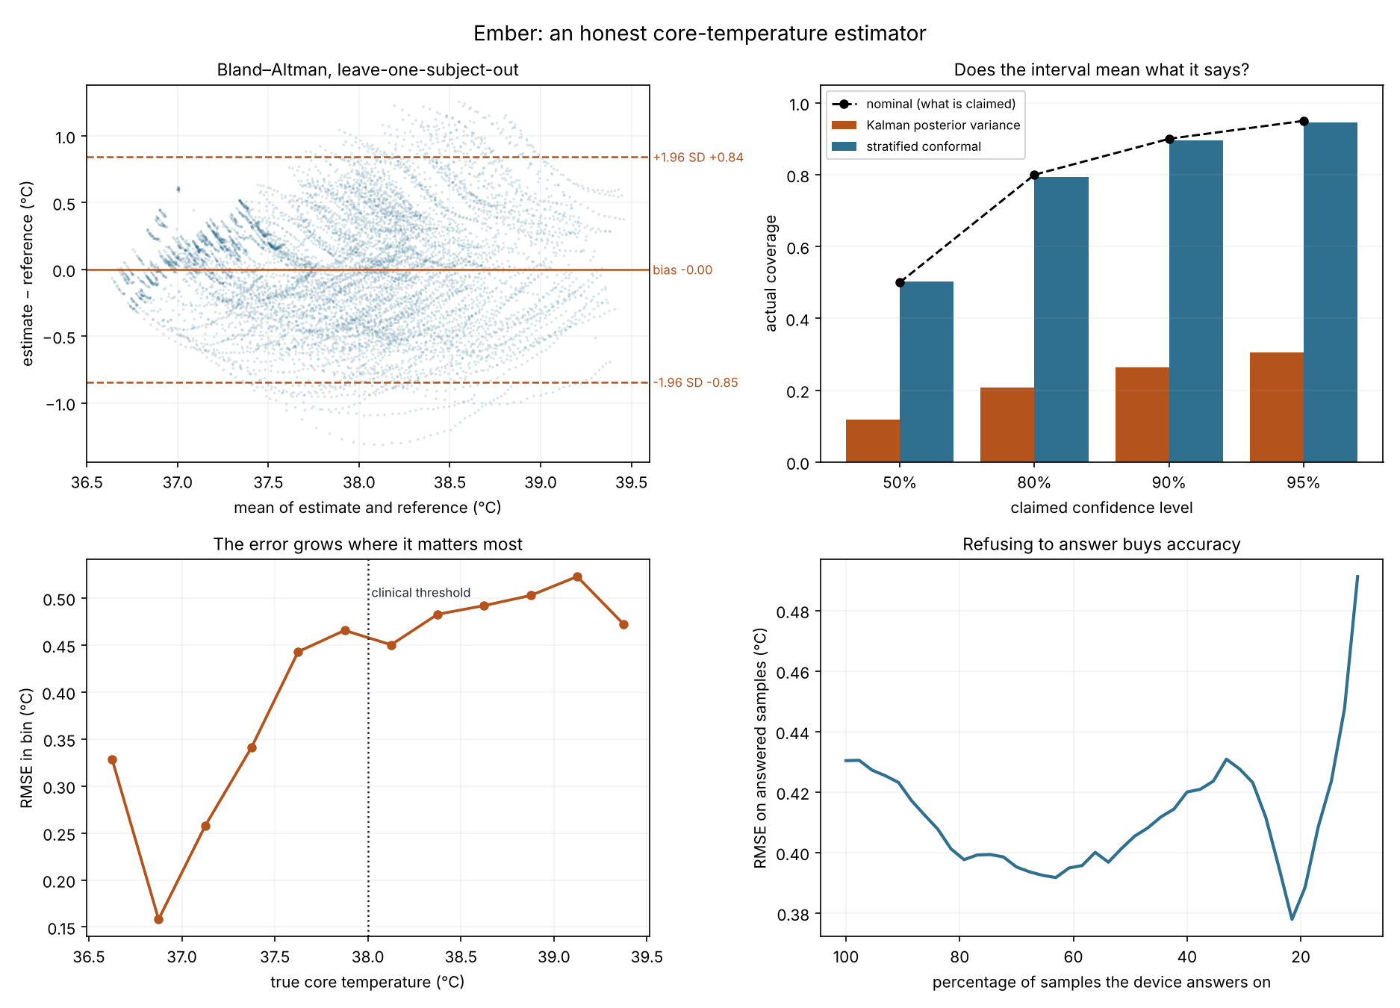
figures/ember_results.png
