XBFBolt/ember/(commit log)

2026-10-24 Initial commit: Ember core temperature monitoring system
    - ESP32-S3 firmware with Kalman filter and conformal intervals
    - Python analysis pipeline with PROSPIE dataset evaluation
    - Web application with Personal, Coach, and Supervisor views
    - Complete documentation and build guides
2026-10-24 Phase 2: align calibration with shipped table, fix alert timing, refresh results
    - evaluate.py uses 6 strata (same as conformal_table.h) and the 5,000-resample bootstrap from judges_results.py
    - export_firmware_table.py writes the webapp table too (--js-out)
    - alert timing measured at the minute true core reaches 38.5; pulse-sensor and missing-HR checks added
    - figures recomputed from data; docs, TODO and the How sure sheet updated
    - Personal footer uses the required disclaimer
    - removed stale all-sensor outputs, duplicate header and KIRO_PROMPTS.md
2026-10-24 Phase 3: Ember v2.1 firmware with safety fixes
    - Bring in the v2 build package (firmware/ember, tests, tools, cad, guide,
    docs/APP_INTERFACE.md). Retire the v1 sketch; move the real PROSPIE
    calibration table into firmware/ember/.
    - Never refuse at or above 38.0 C: the worst state there is CAUTION, and
    the number and a widening +/- are always sent.
    - Cadence check keeps real running heart rate: reject a channel only if it
    jumped from the last good minute (remembered for 3 lost minutes) or
    disagrees with the other sensor.
    - "High HR while still": 10 min grace after moving; off at 38.0 C and
    above, and when no motion sensor was found.
    - Remove the width-based refusal (bit 0x0010 res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
2026-10-24 Phase 4: Web Bluetooth hookup (software; not yet tested on a board)
    - frame.js: decodeFrame/encodeFrame ported from ember_ble.py / ember_core.h,
    flag bits, reason order and text checked against ember_core.h
    - ble.js: Web Bluetooth connect, notifications, commands, auto-reconnect
    - device.js: one active source (demo, Bluetooth, USB), BASELINE routing,
    stall watchdog, failed first connect falls back to the demo
    - sim.js: demo emits real v2 frames through the same decoder
    - serial.js: 24-column bench CSV mapped to the frame shape, REFUSE blanked
    - datastore.js: ingestFrame, setSource/setLink, Starting vs Paused from the
    pulse byte, failed-baseline detection, no stale number after a reconn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
2026-10-24 Phase 3b/5: hardware v5, firmware 2.2.2, replay sample, Kiro steering
    - Hardware v5: one pulse sensor, air thermistor on GPIO5, no SHT40.
    Firmware 2.2.2: single-channel cadence check, NO_AIR (0x1000),
    CAL without a reference sensor, upside-down divider fix
    (NTC_*_ON_TOP). Bits 0x0002/0x0080/0x0100/0x0200 reserved.
    - Frame layout unchanged; bytes 14, 15, 18, 19 sent as "none".
    Updated together in ember_core.h, ember_ble.py, APP_INTERFACE.md,
    frame.js, serial.js, sim.js, datastore.js, PersonalView.js.
    - Webapp: "Replay sample" plays webapp/demo/resting_sample.csv
    (generated, not a recording) through the real frame path.
    - Build guide, diagrams and docs/BUILD_GUIDE.md updated for v5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
2026-10-24 Phase 2b: learned correction (firmware 2.3.0), emergency help chat
    - Learned linear correction on top of ECTemp, capped at +/-1.0 C and off
    until BASELINE (analysis/correction.py, nested LOSO). Generated
    coefficients, corrected and raw conformal tables, and golden vectors
    (tests/correction_vectors.h) from export_firmware_table.py.
    - Firmware 2.3.0: struct Correction in ember_core.h, stepped once a minute
    after the filter; all decisions use the shown estimate. 191 core tests.
    - Webapp: demo and Coach use the corrected +/-; "How sure" sheet explains
    the correction. New Emergency help chat (assistant.js, HelpChat.js):
    static 911 bar and first-aid steps, plus Claude via a key pasted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
2026-10-25 Analysis: HTT external test and three new judge figures
    - External test: shipped 2.3 calibration applied unchanged to the HTT dataset (DOI 10.17632/g5sb382smp.1, CC BY 4.0, 65 people). 90% range covered 82.0%; RMSE 0.490 -> 0.395. load_htt.py, external_test.py, results .txt/.json.
    - make_judge_figures.py adds judges_rmse.png (RMSE filter alone vs Ember 2.3, PROSPIE and HTT, per person), judges_range.png (promised vs delivered coverage at 50/80/90/95%, width of the 90% range), judges_early_warning.png (trials aligned on true 38.5 C, minutes of warning for Watch and Act now). The first three figures are byte-identical.
    - JUDGES_SUMMARY.md, RESULTS_ONE_PAGER.md, TODO.md updated.
2026-10-25 Final cleanup: README, docs, repo layout
    - Rewrite README for firmware 2.3 and hardware v5: results on PROSPIE
    and the HTT external test, how it works, setup, tests, privacy, limits
    - Update docs/SCIENCE.md with the real results (no synthetic numbers)
    - Add the HTT external test to JUDGES_SUMMARY and RESULTS_ONE_PAGER
    - Refresh figures/ember_results.png and ember_by_sex.png to 2.3
    - Move wiring, schematic, protoboard and cad/ into hardware/
    - Remove planning and handoff files: TODO, HANDOFF, CAD_PROMPT,
    dataset research brief, v1 BUILD_PLAN, design-export, Kiro steering
    - Fix code comments that pointed at removed files (no behaviour change)
